GWXY233/surface-vessel-control-system/hardware/mechanical.md

# RevL1 机械尺寸

板框名义尺寸 69 × 54 mm，圆角 R2。四个孔为 Ø3.5 mm，可用于 M3 螺丝安装。

元件面观察、USB 朝左，以板框外接矩形左下角为原点，x 向右、y 向上，孔心坐标如下，单位 mm。

| 位置 | x | y |
| --- | --- | --- |
| 左下 | 5.5 | 5.5 |
| 右下 | 63.5 | 5.5 |
| 左上 | 5.5 | 48.5 |
| 右上 | 63.5 | 48.5 |

左右孔心距 58 mm，上下孔心距 43 mm。孔中心距相邻直边 5.5 mm。数据来自归档设计，实物尺寸以制造和测量结果为准。
