GWXY233/surface-vessel-control-system/THIRD_PARTY.md

# 第三方内容

项目 MIT 授权覆盖项目原创内容。第三方器件、产品名称、商标、器件库资源和外部软件依赖由各自权利人管理。

- Arduino AVR core 与 Servo 库由 Arduino 及其贡献者维护，使用时遵守各自仓库中的许可。此仓库没有打包这些库的源代码或编译后二进制。
- 嘉立创 EDA 原生工程会携带导入的符号、封装、字体和库元数据，部分为系统库及厂商资源。项目作者不将第三方资源的权利转授为 MIT，使用或再分发这些资源时应核对其来源许可。
- 芯片和连接器数据手册由相应厂商发布，仓库文档以链接形式引用。

依赖与资料入口如下。

- https://github.com/arduino/ArduinoCore-avr
- https://github.com/arduino-libraries/Servo
- https://www.ti.com/lit/ds/symlink/drv8833.pdf
- https://www.onsemi.com/products/standard-products/ldo-voltage-regulators/ncp718
- https://www.aosmd.com/sites/default/files/res/datasheets/AO4407A.pdf
