GWXY233/surface-vessel-control-system/两套水面航行器电控方案.md

# 单桨水面航行器：最终可执行方案

## 先给结论

不要整船、整套电路一比一复刻视频。最终推荐采用**方案二：参考视频的控制架构，但重画接线/载板、改用 2.4 GHz 遥控、加入失控停机和转速上限程序**。这样保留了已经有人跑通的思路，同时满足“自行设计”的要求，成本也低。

方案一“555 电机 + 1:5 减速箱 + 成品电调”可以做机械备份，但它的成败高度依赖实测并设置遥控器油门行程，不作为首选参赛方案。

## 不能改变的比赛约束

- 电池：2S 锂电池，标称 7.4 V；调试和比赛过程中不能换电池。
- 船：单螺旋桨水面航行器，螺旋桨必须保持浸水。
- 尺寸（含桨）：不超过 350 mm × 150 mm × 150 mm。
- 动力只能来自电机带动单桨。
- 操作者把遥控油门推到最大时，螺旋桨转速仍必须不超过 600 r/min。
- 电池电压应便于测量。无需固定电压显示器；将电池平衡插头固定在可打开的干舱口旁，能直接量最外侧两针即可。

## 方案二（最终推荐）：6 V 减速电机 + Nano + L298N + 2.4 G 遥控

### 为什么选它

- 结构和视频相近，容易一次跑通。
- 6 V / 600 r/min 减速电机已经把电机高速降到所需量级。
- L298N、Nano、BEC 都是低价通用模块，坏了容易替换。
- 与视频不同的 2.4 G 遥控、程序失控保护、转速限制和自制载板，能形成自己的设计。

### 确定购买清单

| 部件 | 数量 | 必须选择的规格 | 购买页 |
|---|---:|---|---|
| 25 mm 370 减速电机 | 1 | **6 V、600 r/min**；页面标题应为“DC1.5-7.4V…6V600转” | [淘宝商品 1053892836422](https://item.taobao.com/item.htm?id=1053892836422) |
| L298N 驱动模块 | 1 | **标准两路 L298N、带散热片**；不要选四路小板 | [天猫商品 616558401543](https://detail.tmall.com/item.htm?id=616558401543&skuId=4346322752823) |
| Arduino Nano | 1 | **ATmega328P、CH340、5 V/16 MHz、焊好排针** | [淘宝商品 681576085765](https://item.taobao.com/item.htm?id=681576085765) |
| 2S–6S 航模 BEC | 1 | **输入明确支持 2S；输出固定 5 V；标称 5 A** | [淘宝商品 1047949381348](https://item.taobao.com/item.htm?id=1047949381348&skuId=6239296238913) |
| 2.4 G 遥控器和接收机 | 1 套 | **当前购物车 SKU 5297428864872；页面必须显示遥控器+接收机套装**。4 通道即可，实际只用 2 通道 | [天猫商品 722734850964](https://detail.tmall.com/item.htm?id=722734850964&skuId=5297428864872) |
| SG90 舵机 | 1 | **SG90、180°、带舵盘/螺丝** | [淘宝商品 45239609836](https://item.taobao.com/item.htm?id=45239609836&skuId=3896124449782) |
| 舵机拉杆/防水风琴套 | 1 套 | M2/M3 拉杆；按打印支架孔径选择 | [淘宝商品 693397454685](https://item.taobao.com/item.htm?id=693397454685) |
| 2S/3S B3 平衡充电器 | 1 | **20 W B3、支持 2S/3S；2S 从 JST-XH 平衡口充电** | [淘宝商品 1034993327891](https://item.taobao.com/item.htm?id=1034993327891&skuId=6217834207545) |

已有的 2S 7.4 V、XT60 电池继续使用。XT60 是**放电**接口；B3 充电器接电池的三针 JST-XH **平衡口**，所以充电器不需要 XT60 输出。

另备普通耗材：5 A 汽车片式保险丝与座各 1、主电源开关 1、18 AWG 红黑硅胶线约 1 m、24 AWG 信号线若干、3 mm 和 6 mm 带胶热缩管、100 nF 陶瓷电容 1 个、470 µF/16 V 电解电容 1 个。它们不限定店铺；关键是规格，不建议为了几元耗材分散多家下单。

### 电气连接

```text
2S 电池 XT60 正极
  └─ 5 A 保险丝 ─ 主开关 ─┬─ L298N 的 VM/12V 电机电源端
                           └─ 5 V BEC 输入正极

2S 电池负极 ──────────────┬─ L298N GND
                           └─ 5 V BEC 输入负极

BEC 5 V ─┬─ Nano 5V（绝不能接 VIN）
          ├─ 接收机 VCC
          └─ L298N 5V 逻辑端

BEC GND ─┴─ Nano GND ─ 接收机 GND ─ L298N GND（必须共地）

接收机 CH1 ─ SG90（转向）
接收机 CH2 信号 ─ Nano D2（油门）
Nano D5 ─ L298N ENA（先拔掉 ENA 跳帽）
Nano D7 ─ L298N IN1
Nano D8 ─ L298N IN2
L298N OUT1/OUT2 ─ 6 V/600 r/min 减速电机
```

必须拔掉 L298N 的 `5V-EN` 跳帽，再由独立 BEC 给 L298N 逻辑 5 V。不要用 L298N 自带线性稳压器带接收机和舵机。

在电机两端直接焊 100 nF 电容；在 L298N 的 VM 和 GND 入口并联 470 µF/16 V 电容。电解电容有正负极，不能接反。

### 程序和操作

程序位于 [boat_controller.ino](boat_controller/boat_controller.ino)。它具有：

- 接收机断线/脉宽异常立即停机；
- 油门中位死区；
- 正反转切换先停 180 ms；
- 最大 PWM 默认限制在 175/255（68.6%）。

第一次操作顺序：

1. 拆下螺旋桨，电机和桨轴先断开。
2. 用 USB 给 Nano 烧录程序，然后断开 USB。
3. 遥控器油门回中、先开遥控器，再接船上电池。
4. 完成遥控器和接收机对频；确认关掉遥控器时电机立即停止。
5. 检查 CH1 舵机方向和最大角度，舵角先限制在左右约 30°，避免 SG90 堵转。
6. 检查 CH2 油门方向；如果前进反了，交换电机两根线，不要在程序里随意改安全逻辑。
7. 接上桨轴，仍不装桨，检查振动、同轴度和温升。
8. 装桨后用**充满的 2S 电池（约 8.4 V）**测最高转速。满油门目标 500–550 r/min；超过 550 就把程序 `MAX_PWM` 从 175 调低，每次减 5 后复测。
9. 在水中连续运行 3 分钟，再摸 L298N 散热片和电机外壳。烫到手不能持续接触就停机，检查桨轴阻力或降低 `MAX_PWM`。

### 自制 PCB 应该怎么做

第一版不要把降压芯片、H 桥功率管、主控全部做成裸芯片的一体板。做一块**模块载板**：插 Nano、L298N、BEC，板上只集成保险丝、开关、插座、电容和测试点。这样既算自己的电控设计，又不会因为一处焊错导致整船不能参赛。

PCB 要点：电池和电机回路走线宽至少 2.5–3 mm，最好 2 oz 铜；电机地和控制地在电池负极附近单点汇合；XT60、保险丝、L298N、电机连接端子沿板边布置；留 `BAT+`、`BAT-` 两个带绝缘护套的电压测试点。

## 方案一（机械备份）：555 + 1:5 行星减速 + 有刷电调

### 确定配置

- 电机/减速器：**DC12V–24V、555、有刷、1:5 行星减速箱、前滚珠轴承**，深圳杰盛电机，约 14.8 元。[商品详情/淘宝跳转](https://tao.hooos.com/goods_e6KVJaxiDtdeDWW8xPS8XMuzt0-DokRR8I69vw8d6Bs6.html)
- 电调：**60 A 有刷防水电调，XT60 版本 Q1936-XT60**。[淘宝商品 911887023070](https://item.taobao.com/item.htm?id=911887023070&skuId=5942766926743)
- 遥控器、接收机、SG90、舵机拉杆和 B3 充电器与方案二相同。
- 不需要 Nano、L298N 和 5 V BEC，因为该电调自带 6 V/3 A BEC 给接收机和 SG90 供电。

买电调前，商品选项文字必须显示 `60A有刷电调XT60头 Q1936-XT60`，并向客服确认“输入支持 2S 7.4 V 锂电”。如果客服回答不支持 2S，就不买该款。

### 接线与操作

```text
2S 电池 XT60 -> 5 A 保险丝/主开关 -> 有刷电调 XT60
电调两根电机线 -> 555 电机
电调三芯接收线 -> 接收机 CH2
SG90 -> 接收机 CH1
```

该 555 商品没有给出足够可靠的 2S 空载输出转速，所以**不能买回来就把油门行程设 100%**。第一次把 CH2 油门 EPA/行程设为 50%，满电实测桨速；每次增加 5%，直到满油门约 500–550 r/min。若遥控器不支持 EPA，就不能把这一套作为最终参赛方案。

方案一的缺点是电机和减速器更重、机械冲击更大、输出转速必须靠实测限制；优点是控制器简单、防水电调比 L298N 更抗电流冲击。因此它只作为赶工备份。

## 3D 打印与防水

- 电机支架、舵机座和载板托架都可以自己打印，不用购买金属支架。
- SG90 不防水，必须放在干舱内；舵机拉杆穿舱处使用风琴套或油脂密封。
- 电机焊点、开关焊点和裸露接头使用带胶热缩管。热缩管不是为了“好看”，而是防短路、应力断线和潮气。
- L298N、Nano、接收机和 BEC 全部放在可拆的干舱中；不要用热熔胶直接糊住散热片。

## 最终验收清单

- [ ] 满电 2S、遥控满油门时，实测桨速不超过 600 r/min；建议控制在 500–550。
- [ ] 关闭遥控器或拔掉接收机信号后，电机 1 秒内停转。
- [ ] 电池平衡口或测试点可在不拆整船的情况下测量总电压。
- [ ] 连续水中运行 3 分钟，无驱动过热、接头发热、舵机堵转。
- [ ] 单桨始终浸水，整船含桨不超 350 × 150 × 150 mm。
- [ ] 结构、载板/接线和程序为自己设计，答辩时能解释每个模块作用。

只做一套时，按**方案二**买和做；方案一不用同时买。
