GWXY233/surface-vessel-control-system/两套水面航行器电控方案_已验证版.md

# 单桨水面航行器：当前已验证电控系统

## 当前结论

当前实际采用并已经完成通电、遥控和电机联调的是：

**2S电池 + 外部5 V降压模块 + Nano + L298N + 2.4 GHz遥控器 + 6 V减速电机 + SG996R舵机。**

当前系统可以正常运行。后续如升级带编码器电机，属于另一个版本，需要修改接线和程序；目前不要把编码器方案和现有系统混用。

## 比赛约束

- 电池：2S锂电池，标称7.4 V，满电约8.4 V。
- 船：单螺旋桨水面航行器，螺旋桨必须浸水。
- 整船含螺旋桨尺寸不超过350 mm × 150 mm × 150 mm。
- 动力只能来自电机带动单桨。
- 遥控器满油门时，螺旋桨转速不得超过600 r/min。
- 电池电压应能方便测量。

## 模块作用

| 模块 | 作用 |
|---|---|
| 2S电池 | 给L298N的电机动力端供电 |
| 5 V降压模块/BEC | 给Nano、接收机、舵机和L298N逻辑端供电 |
| Arduino Nano | 读取遥控器CH2油门信号，输出PWM和正反转控制 |
| L298N | 根据Nano的控制信号驱动电机 |
| 2.4 GHz接收机 | 接收遥控器CH1、CH2信号 |
| SG996R | 通过CH1控制方向 |
| 6 V减速电机 | 通过L298N驱动单桨 |
| 保险丝和主开关 | 保护和控制整船主电源 |

## 最终电源接线

### 电池动力分支

```text
2S电池XT60正极
        │
      保险丝
        │
      主开关
        │
        ├── L298N VM/12V
        └── 降压模块 BAT+/IN+

2S电池XT60负极
        ├── L298N GND
        └── 降压模块 BAT-/IN-
```

L298N上的“12V”是电机电源输入端，不是固定要求12 V。2S电池的7.4～8.4 V可以接入该端子。

### 5 V控制电源分支

```text
降压模块 OUT+/5V+
        ├── L298N 5V
        ├── Nano 5V
        └── 接收机CH2的+

降压模块 OUT-/GND
        ├── L298N GND
        ├── Nano GND
        └── 接收机CH2的-
```

所有GND必须共地。

注意：

- Nano接5 V脚，不能接VIN。
- 降压模块输出必须是约5.0 V。
- 不能把6 V输出接到Nano的5 V或L298N的5 V。
- USB烧录时不要同时接外部5 V给Nano。

## 降压模块设置

如果降压模块通过焊盘选择输出电压：

1. 断开电池和所有负载。
2. 按模块标识选择5 V焊盘。
3. 不要同时短接5 V和6 V选择焊盘。
4. 单独给降压模块输入2S电池。
5. 用万用表测OUT+与OUT-，确认约5.0 V。
6. 确认后再接L298N、Nano和接收机。

如果降压模块空载能输出5 V，但接入SG996R后电压明显下降，说明模块电流能力不足或线路接触不良，应更换额定至少3 A、建议5 A的5 V BEC/降压模块。

## L298N跳帽

正式接线时：

- `5V-EN`：拔掉。
- `ENA`：拔掉。
- `ENB)：B路未使用，可保持原状态。

`5V-EN`只能在外部5 V已经接到L298N的 5V和GND后再拔掉。没有外部5 V时拔掉它，Nano、接收机和L298N逻辑部分全部不亮是正常现象。

L298N自带稳压器空载时可能测到约5.1 V，但SG996R动作时会因为启动电流较大而掉压，造成Nano、接收机和驱动板闪烁或重启。因此不能把L298N自带稳压器作为正式5 V电源。

## 接收机接线

接收机通道排针标识为：

```text
S = 信号
+ = 5 V
- = GND
```

### CH1：方向舵机

```text
SG996R黄色线 → CH1 S
SG996R红色线 → CH1 +
SG996R棕色线 → CH1 -
```

### CH2：油门信号

```text
接收机CH2的S → Nano D2
接收机CH2的+ → 5 V
接收机CH2的- → GND
```

接收机CH3、LED和BIND/LIGHT接口不用。

## Nano与L298N信号线

```text
接收机CH2 S → Nano D2
Nano D5 → L298N ENA
Nano D7 → L298N IN1
Nano D8 → L298N IN2
L298N OUT1/OUT2 → 电机两根线
```

程序使用D5输出PWM：

- D5控制电机速度；
- D7、D8控制电机正反转；
- 油门回中时停止；
- 正反转切换前先停180 ms。

如果前进方向反了，交换L298N OUT1和OUT2接到电机的两根线。

## 抑制干扰和电源波动

- 100 nF陶瓷电容：并联在电机两端。
- 470 µF/16 V电解电容：并联在L298N的VM和GND入口。
- 电解电容正极接VM，负极接GND，不能接反。
- 电机、保险丝、开关和电池线使用较粗导线。
- 信号线与电机动力线尽量分开布置。
- 接头焊点使用热缩管和应力释放，防止振动和潮气造成虚焊。

## 程序

程序文件：

[boat_controller.ino](D:/document/ChatGPT/3dzengjiancai/boat_controller/boat_controller.ino)

程序功能：

- 接收机断线或脉宽异常立即停机；
- 油门中位死区；
- 正反转切换先停180 ms；
- 最大PWM默认限制为175/255，约68.6%。

当前程序仍然是开环控制，没有编码器反馈。最大PWM不是600 r/min的绝对保证，最终仍需要使用激光转速表或其他转速测量方式确认。

## 烧录与第一次启动

1. 拆下螺旋桨，最好断开桨轴。
2. 断开船上电池和外部5 V。
3. USB连接Nano并烧录程序。
4. 烧录完成后拔掉USB。
5. 确认遥控器油门回中。
6. 先开遥控器，再接通船上主电源。
7. 检查接收机指示灯和SG996R动作。
8. 轻推CH2油门，检查电机正反转。
9. 确认关闭遥控器后电机停止。
10. 检查L298N散热片、降压模块和SG996R是否异常发热。
11. 安装螺旋桨后，在实际入水状态测量最高转速。

建议把满油门转速控制在500～550 r/min，绝不能超过600 r/min。

## SG996R注意事项

SG996R比SG90需要更大的启动电流：

- 必须使用稳定的外部5 V电源；
- 舵角先限制在左右约30°；
- 避免连杆或舵面机械堵转；
- 舵机应放在干舱内；
- 拉杆穿舱处使用风琴套或油脂密封。

## 编码器电机升级方向（未安装）

后续如果要升级闭环测速，可考虑25 mm级的GA25-370-0660-EN，减速比9.6版本。图片参数显示：

- 6 V；
- 空载约620 r/min；
- 额定负载约450 r/min；
- 重量约100 g；
- 尺寸比37 mm级电机更适合当前船体。

下单前必须确认：

- 编码器供电电压；
- A/B两相还是单路脉冲；
- 每转脉冲数；
- 编码器安装在电机轴还是减速箱输出轴；
- 输出轴直径、长度和安装孔位。

编码器电机不会自动限速。更换后需要给Nano增加测速和闭环PWM控制。当前接收机油门使用D2，如果编码器占用D2，还要调整油门信号引脚和程序。

## 当前验收清单

- [ ] 外部降压模块输出约5.0 V。
- [ ] `5V-EN`和`ENA`按要求处理。
- [ ] 2S电池经过保险丝和开关接L298N VM。
- [ ] Nano、接收机、L298N和降压模块共地。
- [ ] SG996R左右动作正常，无机械堵转。
- [ ] 遥控器失控后电机停止。
- [ ] 满电2S、满油门时桨速不超过600 r/min。
- [ ] 水中连续运行3分钟，无驱动过热和接头发热。
- [ ] 单桨始终浸水，整船含桨不超过350 × 150 × 150 mm。
- [ ] 电池平衡口或测试点可方便测量。
- [ ] 答辩时能说明VM/12V为电机电源，5V为逻辑电源，以及5V-EN/ENA的作用。
