GWXY233/surface-vessel-control-system/legacy/l298n-single-servo/README.md

# 早期 L298N 单舵方案

这里保留 2026-08-17 首次提交的原始 Arduino 程序与两份电控文档，供复现和版本对比。

- `boat_controller/boat_controller.ino` 为早期开环遥控程序。
- 两份中文文档为当时的接线、调试与升级方案。
- 文档中的本机程序链接已调整为当前仓库相对路径，电路说明和程序内容保留。

该版本采用 L298N、单舵机和 CH2 油门，其供电与引脚定义按这些历史文档使用。当前自研板的接线从 [新版接线说明](../../docs/wiring.md) 查阅。
