GWXY233/surface-vessel-control-system/hardware/revl1/bom.csv

References | Quantity | Specification | Package | ManufacturerPart
R1 | 1 | 0.1 ohm 1% 1W | 2512 | RL2512FK-070R1L
R2,R3,R7,R9,R11,R13,R14 | 7 | 100 kohm | 0603 | 0603WAF1003T5E
R4,R5,R16 | 3 | 10 kohm | 0603 | 0603WAF1002T5E
R6,R8,R17 | 3 | 1 kohm | 0603 | 0603WAF1001T5E
R10,R12 | 2 | 100 ohm | 0603 | 0603WAF1000T5E
R15 | 1 | 33 kohm | 0603 | 0603WAF3302T5E
C1 | 1 | 10 uF 50V ceramic | 1210 | CS3225X7R106K500NRL
C2,C8,C10,C11,C12 | 5 | 100 nF ceramic | 0603 | CC0603KRX7R9BB104
C3 | 1 | 10 nF ceramic | 0603 | CL10B103KB8NNNC
C4 | 1 | 2.2 uF 10V ceramic | 0805 | GRM21BR71A225KA01L
C7,C9,C13,C14 | 4 | 10 uF 50V ceramic | 0805 | GRM21BR61H106KE43L
C5 | 1 | 220 uF 16V polarized | D8mm pitch3.5mm | 16SEPC220MD
C6 | 1 | 470 uF 10V polarized | D5.5x9mm pitch2.5mm | RYHS10V470UF5.5*9
U1 | 1 | DRV8833PWPR motor driver | HTSSOP16 PowerPAD | DRV8833PWPR
U2 | 1 | NCP718ASN500T1G fixed5V LDO | TSOT23-5 | NCP718ASN500T1G
Q1 | 1 | AO4407A P-MOS | SOIC8 | AO4407A
D1,D2 | 2 | SS34 Schottky | SMA | SS34
F1 | 1 | 8A fuse | 2410 | 0451008.MRL
LED1 | 1 | Green LED | 0603 | XL-1608UGC-04
JN1,JN2 | 2 | Female header 1x15 | pitch2.54mm | PM2.54-1*15
JP1 | 1 | Male header 1x2 plus conductive jumper | pitch2.54mm | 2.54-1*2
J5,J6,J7,J8 | 4 | Male header 1x3 | pitch2.54mm | PZ254V-11-03P
J9,J10 | 2 | Male header 1x4 | pitch2.54mm | 2.54-1*4
J1,J4 | 2 | XT30UPB-M PCB male | pitch5mm drill1.8mm verify real pin fit | XT30UPB-M
J2,J3 | 2 | DG350 2-pin screw terminal | pitch3.5mm | DG350-3.5-02P-14-00A(H)
