GWXY233/surface-vessel-control-system/docs/wiring.md

# RevL1 接线

方向约定为元件面朝向观察者，Nano USB 朝左。现版 Nano 从元件面插入两排排母。

## 单块降压模块

```text
2S 电池 → 总开关 → J1 → 板上保护 → J3 → 降压模块 IN
降压模块 OUT 调为 6.0 V → J4 → 板上驱动 舵机和 5 V 稳压支路
```

| 接口 | 针脚与朝向 | 外部连接 |
| --- | --- | --- |
| J1 BAT | 左 2 为 BAT_RAW 正，右 1 为 GND | 总开关后的电池正负 |
| J3 BUCK IN | 左 1 为 BAT_SW，右 2 为 GND | 降压模块 IN+、IN− |
| J4 6V IN | 左 2 为 +6V_BUS，右 1 为 GND | 降压模块 OUT+、OUT− |
| J2 MOTOR | 下 1 为 MOTOR_A，上 2 为 MOTOR_B | 电机两根动力线 |

J4 接降压模块输出。两根电机线都接驱动输出，不能把其中一根当作公共地。板载 NCP718 的固定 5 V 输出供 Nano、接收机、编码器和显示屏。

## 接收机与双舵

J5～J8 从上到下均为 S、正电源、GND，其中 J5/J8 正电源是 5 V，J6/J7 是 6 V。

| 外部器件 | 主板接口 | 接法 |
| --- | --- | --- |
| 已配对接收机 CH1 | J5 | S 对 S，正极对中间 5 V，负极对 GND |
| 接收机 CH2 | J8 | 当前 V5.4 不需要接 CH2 油门 |
| 左舵机 | J6 | 橙或黄接 S，红接中间 6 V，棕或黑接 GND |
| 右舵机 | J7 | 同 J6，分别插入各自接口 |

选用明确支持 6 V 的角度定位舵机。样机使用两只卖家标称支持 3～7.2 V 的 SG90，这个规格不能推广到所有 SG90。

## 电机与编码器线色

样机电机线束的颜色如下，替换线束时以编码器板标记为准。

| 颜色 | 功能 | 主板 |
| --- | --- | --- |
| 白 | Motor + | J2.1 MOTOR_A |
| 红 | Motor − | J2.2 MOTOR_B |
| 黑 | 编码器 GND | J9.1 |
| 蓝 | 编码器 VCC | J9.2，5 V |
| 绿 | 编码器 A | J9.3，Nano D7 |
| 黄 | 编码器 B | J9.4，Nano D12 |

J9 从左到右为黑、蓝、绿、黄。红线属于电机动力线。当前程序计数 A 相上升沿，B 相预留。

## 四位数码屏

| 显示模块标记 | 主板接口 | Nano |
| --- | --- | --- |
| CLK | J10.4 | A4 |
| DIO | J10.3 | A5 |
| VCC | J10.2，5 V | 5 V 支路 |
| GND | J10.1 | 公共地 |

J10 从左到右为 GND、5 V、DIO、CLK。对照信号名称连接。该 CLK/DIO 显示协议使用固件内置驱动。

## JP1 与上传

电池独立运行时，用内部导通的跳帽接通 JP1。普通绝缘排母不能代替跳帽。上传时断开电池，取下 Nano 单独接 USB，完成后拔 USB 再恢复安装和供电。
