GWXY233/surface-vessel-control-system/docs/verification.md

# 验证记录

## 硬件归档

RevL1 J4 丝印修正版归档于 2026-10-21。原生 PCB DRC 记录为 0 个违规，51 个元件、160 个焊盘网络、965 条铜线段和 62 个过孔。

旧记录中的布局回读、网络对账和丝印修订已经完成。发布时重新检查了原生归档 ZIP 完整性，发布副本与源文件的 SHA256 一致。独立环境导入还原、制造适配、持续电流和整机温升仍待验证。

## 软件结果

V5.4 已在经典 Nano ATmega328P、16 MHz、AVR core 1.8.8 与 Servo 1.3.0 环境编译，正常版使用 11500 字节 Flash、556 字节静态 SRAM。

- [控制模型](verification/control-model.json) 为实际 AVR HEX 与假设电机模型的回归，包含正常运行、负载变化、反馈丢失、堵转、超速、驱动故障和遥控失联等场景。
- [显示检查](verification/display-checks.json) 检查 580、595、600、601、650、1000 的数字显示、原始数值保留与 E002 优先级。
- [双舵检查](verification/servo-checks.json) 检查脉宽端点、响应、帧周期与回中。

这些模型没有拟合实船参数，不能据此保证实际最高转速、转向角、电流或5%测速精度。

## 发布前复核

2026-11-09 对准备公开的文件重新核对。原生工程副本 SHA256 与本地归档一致，BOM 按 51 个板上元件对账，文档相对链接检查通过。原始旧程序内容与仓库首次提交逐字节归一化对比一致。

使用同一经典 Nano 编译目标重新编译三份发布源码，V5.4 为 11500 字节 Flash / 556 字节静态 SRAM，PWM 诊断程序为 11632 / 556 字节，早期 L298N 程序为 1740 / 10 字节。发布文件的文本、PDF 可提取文字与原生工程文本未发现本机绝对路径、个人邮箱或常见访问令牌。

## 样机记录

2026-11-09 开源提交前，通过已连接编辑器重新保存并 typed 回读 PCB。51 个元件、板框及铜数据与归档快照语义哈希一致：`1433cd4f90c973e69b348bc466878d327d525ce2ed985b36ab2b0ef89bb921b7`。未修改电路与布线。嘉立创已返回“提交成功，请等待后台审核”，详情页能读取原理图/PCB预览、BOM及ZIP附件；这不等于平台审核通过的证明。

近期联调反馈约为水中 580 r/min，未装桨但仍带轴套和联轴器时约 586 r/min。该读数来自板载编码器，尚无同工况独立转速计与重复负载试验记录。更换电机、联轴器角度、电池状态和降压模块设置后需重新记录。
