GWXY233/surface-vessel-control-system/docs/known-issues.md

# 已知问题与复刻边界

## XT30 插脚匹配待核实

J1/J4 设计型号为 XT30UPB-M 板焊公针型。归档封装两脚间距 5.0 mm，钻孔 1.8 mm。样机装配中曾反馈购买的 XT30 插脚无法插入，尚未收到足够的实物型号和尺寸信息，原因仍待确认。

复刻前核对实际连接器型号、脚径与封装图，必要时修订封装后重新检查。插不进时不要强压或直接钻大成品板孔，以免损坏孔壁镀铜。

## Nano 安装版本

本仓库硬件为已纠正映射的 RevL1，Nano 从元件面插入，USB 朝左。历史 RevJ 曾存在接口映射错误，旧版背面安装补救方法不适用于这份新板。

## 输出与测量

V5.4 的数字显示在 600 封顶，评估实际转速峰值时使用串口原始反馈或独立测速。610 只是软件触发撤驱动的阈值，驱动关闭后仍存在机械惯性。

当前校准与 9.6∶1 样机减速电机配套。更换电机、编码器或传动比时重新计数，普通万向节的角度也可能引起瞬时速度波动。

## 电源与散热

板载 NCP718 为 300 mA 级 LDO，5 V 总负载与温升仍需按实际接收机、Nano、编码器和显示屏核算。外接模块曾按 8 A 级选型，但实际持续输出能力未完成负载验证。8 A 保险丝与系统线束的协调也需实测。

U1 底部散热盘焊接、驱动限流、起动和减速尖峰、回送能量以及电池/BMS 的接受能力尚需示波器与实板验证。DRC 结果仅覆盖设计规则检查。

## 原生工程与制造输出

原生归档的 ZIP 完整性已核对。独立环境的导入还原验证尚待完成，文件内部沿用早期 MG996R 工程名称，当前器件与接口以 RevL1 文件和本仓库说明为准。

仓库提供设计源文件与 BOM，制造文件需在核对器件封装、插接方向、线宽、孔径和规则后导出。
