GWXY233/surface-vessel-control-system/(commit log)

2026-08-17 备份已验证的水面航行器电控系统
2026-11-09 Publish RevL1 boat controller and retain L298N reference design
    [bom.csv, external-parts.csv, servo-checks.json]
2026-11-09 Add V5.4 printable quick start and offline package entry
2026-11-09 docs: add OSHWHub project and complete assembly-to-operation guide
